hightower70/MIDIUSB/Hardware/README.md

# MIDIUSB - Hardware files
MIDI to USB converter cable using STM32F103 microcontroller. This folder contains the hardware design files in DipTrace schematics and PCB format.
