hightower70/MIDIUSB/Hardware/Schematics.pdf

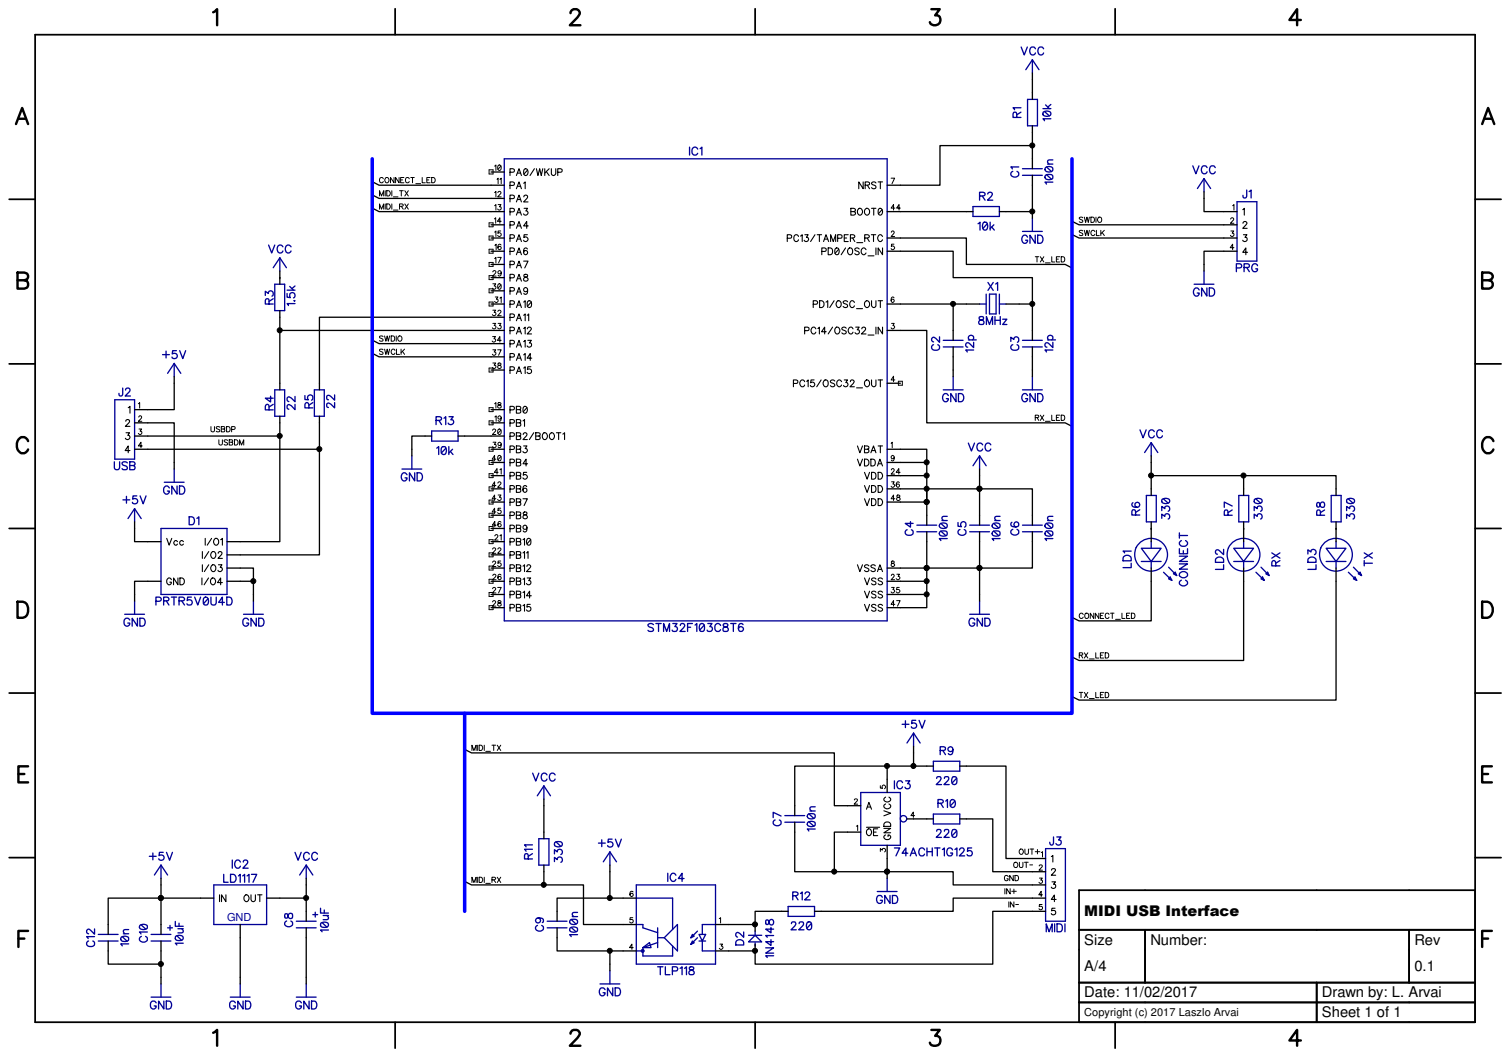
[picture p1: page 1]
GND; MIDI USB Interface

Size A/4 | Number: | Rev 0.1

Date: 11/02/2017 | Drawn by: L. Arvai
Copyright (c) 2017 Laszlo Arvai | Sheet 1 of 1
