hightower70/MIDIUSB/(list of files, drawings)

Other design files:
Hardware/MIDICable.dip
Hardware/MidiUSB.dch
