hightower70/MIDIUSB/Firmware/LibOS/STM32F103MIDIUSBBoard/Include/mxconstants.h

/**
  ******************************************************************************
  * File Name          : mxconstants.h
  * Description        : This file contains the common defines of the application
  ******************************************************************************
  *
  * COPYRIGHT(c) 2017 STMicroelectronics
  *
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
  ******************************************************************************
  */
/* Includes ------------------------------------------------------------------*/

#define CONNECT_LED_Pin GPIO_PIN_1
#define CONNECT_LED_GPIO_Port GPIOA
#define TX_LED_Pin GPIO_PIN_13
#define TX_LED_GPIO_Port GPIOC
#define RX_LED_Pin GPIO_PIN_14
#define RX_LED_GPIO_Port GPIOC
/**
  * @}
  */ 

/**
  * @}
*/ 

/************************ (C) COPYRIGHT STMicroelectronics *****END OF FILE****/
