hightower70/MIDIUSB/Firmware/Include/sysConfig.h

#ifndef __sysConfig_h
#define __sysConfig_h

#include <stm32f1xx.h>
#include <stm32f1xx_hal.h>
#include <mxconstants.h>


///////////////////////////////////////////////////////////////////////////////
// MIDI config
#define midiOUT_BUFFER_MAX_EVENT_COUNT 2048
#define midiIN_BUFFER_MAX_EVENT_COUNT 256
#define midiTRANSMIT_BUFFER_SIZE 256

#endif
