hightower70/MIDIUSB/(commit log)

2017-02-03 Source restructured
    [MIDICable.dip]
2017-02-03 LED handling fixes, Sysex input fixes
    [appMain.c, midiInput.c]
2017-02-05 USB OUT endpoint bugfix, source cleanup
    [midiEventQueue.c, midiEventQueue.h, midiInput.c, midiInput.h, midiOutput.c, midiUSB.c]
2017-03-27 Schematics fix, LED remapping
    [MIDICable.dip, MIDICable_0_2.dip, MidiUSB_0_2.dch]
2017-12-23 Hardware documentation update
    [MIDICable.dip, MIDICable_0_2.dip, MidiUSB.dch, MidiUSB_0_2.dch]
2018-04-23 Cable name changing has been implemented
2018-10-05 Cable name and USB PID can be changed together
2020-06-07 STM32CubeIDE files has been added
